bodgery/pico_doorbot/README.md

Required libraries:

* Dictionary: https://github.com/arkhipenko/Dictionary
* Tone32: https://github.com/lbernstone/Tone32
