bodgery/pico_doorbot/pico_hat/pico_hat.kicad_pcb

## KiCad design pico_hat/pico_hat.kicad_pcb (2021-09-29)

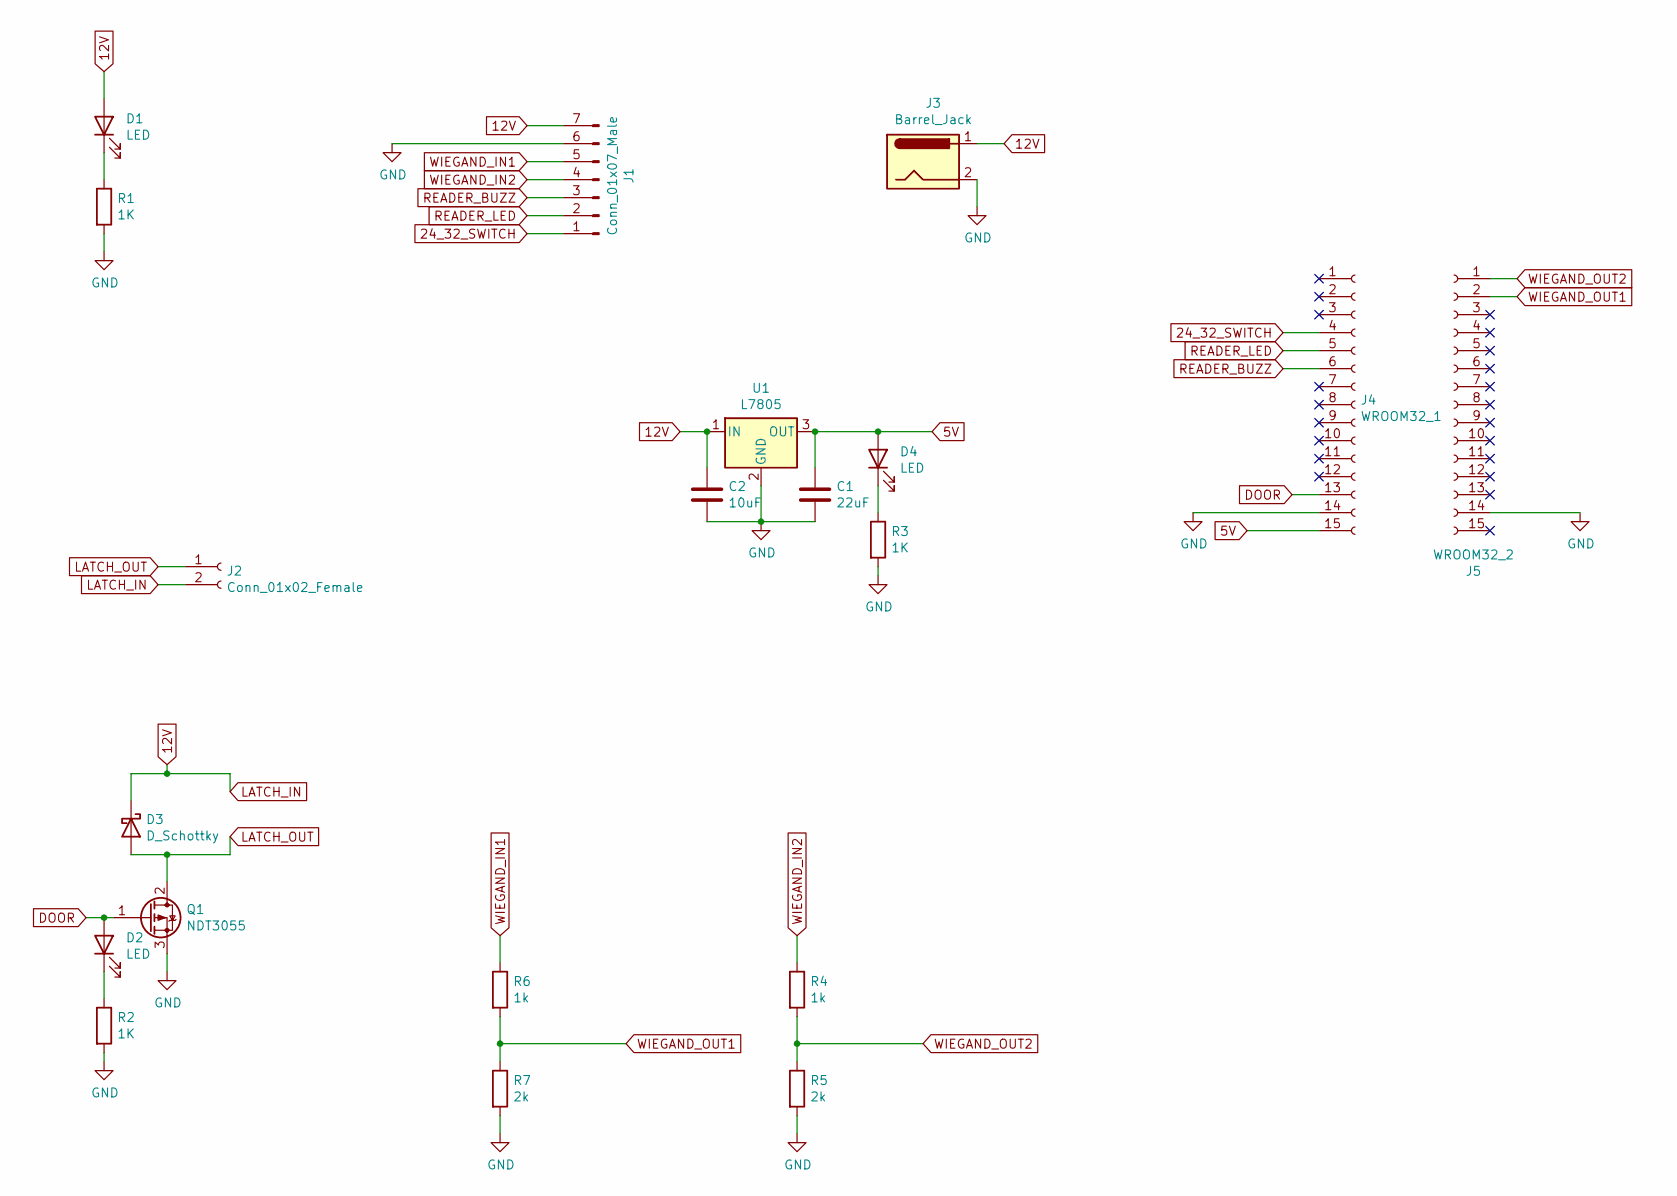
[picture p1: schematic pico_hat.kicad_sch]

Parts:
C1: 22uF; C_1206; Digikey # 1276-1771-2-ND
C2: 10uF; C_1206; Digikey # 1276-6736-1-ND
D1: LED; LED-1206; Digikey # 1516-1073-2-N
D2: LED; LED-1206; Digikey # 1516-1072-2-ND
D3: D_Schottky; SMD-1206_Pol; Digikey # 478-7805-2-ND
D4: LED; LED-1206; Digikey # 1516-1076-2-ND
J1: Conn_01x07_Male; Pin_Header_Straight_1x07
J2: Conn_01x02_Female; TerminalBlock_Pheonix_MKDS1.5-2pol; Digikey # ED2561-ND
J3: Barrel_Jack; TerminalBlock_Pheonix_MKDS1.5-2pol; Digikey # ED2561-ND
J4: WROOM32_1; Pin_Header_Straight_1x15
J5: WROOM32_2; Pin_Header_Straight_1x15
Q1: NDT3055; SOT-223; Digikey # NDT3055CT-ND
R1, R2, R3: 1K; R_1210; Digikey # RMCF1210FT1K00
R4, R6: 1k; R_1210; Digikey # RMCF1210FT1K00
R5, R7: 2k; R_1210; Digikey # P2.0KVTR-ND
U1: L7805; TO-220_Neutral123_Vertical; Digikey # 1470-VR10S05-ND

Connections:
5V: C1.1, D4.2 (A), J4.15, U1.3 (OUT)
12V: C2.1, D1.2 (A), D3.1 (K), J1.7, J2.2, J3.1, U1.1 (IN)
24_32_SWITCH: J1.1, J4.4
DOOR: D2.2 (A), J4.13, Q1.1 (G)
GND: C1.2, C2.2, J1.6, J3.2, J4.14, J5.14, Q1.3 (S), R1.2, R2.2, R3.2, R5.2, R7.2, U1.2 (GND)
LATCH_OUT: D3.2 (A), J2.1, Q1.2 (D), Q1.4
unnamed: D1.1 (K), R1.1
unnamed: D2.1 (K), R2.1
unnamed: D4.1 (K), R3.1
READER_BUZZ: J1.3, J4.6
READER_LED: J1.2, J4.5
WIEGAND_IN1: J1.5, R6.1
WIEGAND_IN2: J1.4, R4.1
WIEGAND_OUT1: J5.2, R6.2, R7.1
WIEGAND_OUT2: J5.1, R4.2, R5.1

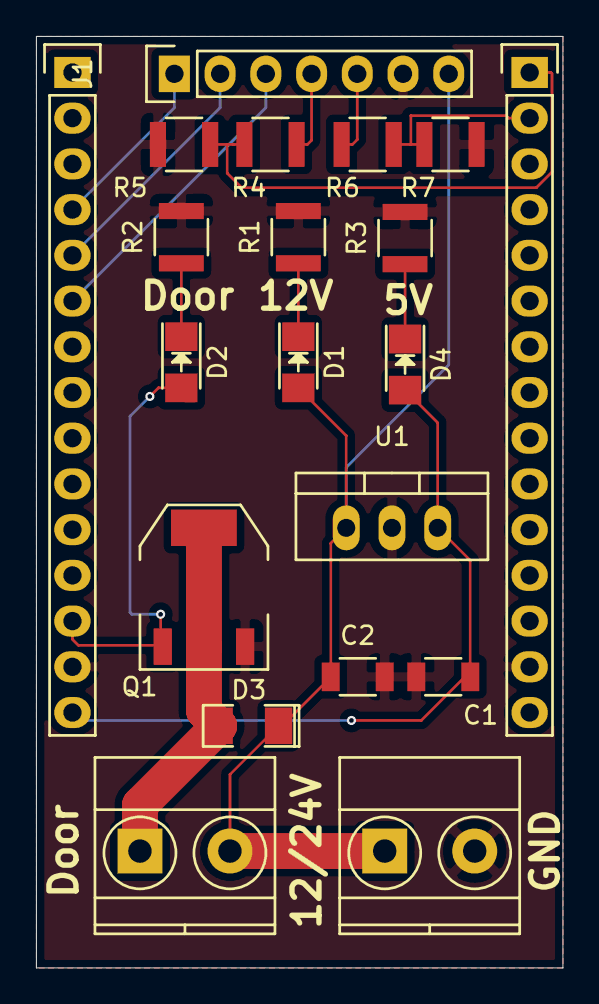
[picture p2: board pico_hat.kicad_pcb from above]

Board: 2 copper layers, 29.2 x 51.8 mm, 20 parts (0 on the bottom side), 15 nets.
