bodgery/pico_doorbot/(commit log)

2021-03-06 Rebuild cache on a timer
2021-03-27 Switch to a polling method of checking Wiegand
2021-03-28 Wiegand PCB connector
    [esp32_doorbot.kicad_pcb, esp32_doorbot.sch]
2021-03-31 Use header that attaches to wesp32 board directly
    [esp32_doorbot.csv, esp32_doorbot.kicad_pcb, esp32_doorbot.sch]
2021-03-31 Add part number for 2x10 pin header
    [esp32_doorbot.sch]
2021-04-23 Change schematic for regular ESP32, not a PoE version
    [esp32_doorbot.sch]
2021-04-24 New layout for regular esp32
    [esp32_doorbot.kicad_pcb, esp32_doorbot.sch]
2021-04-24 Use larger components. Correct pinout and spacing
    [esp32_doorbot.kicad_pcb, esp32_doorbot.sch]
2021-07-03 Switch to voltage divider instead of logic level converter
    [esp32_doorbot.kicad_pcb, esp32_doorbot.sch]
2021-07-20 Voltage dividers
    [esp32_doorbot.csv, esp32_doorbot.sch]
2021-07-27 Move opening the door into success/fail methods
    [esp32_doorbot.ino]
2021-07-31 Correct door pin
2021-09-10 Take a command for opening door. Correct pinout on MOSFET.
    [esp32_doorbot.ino]
2021-09-17 Add stats command. Add some stuff that was missing in the example config
    [esp32_doorbot.ino]
2021-09-26 Correct mosfet pinout (for real this time)
    [esp32_doorbot.kicad_pcb, esp32_doorbot.sch]
2021-09-26 Revert "Correct mosfet pinout (for real this time)"
    This reverts commit 8fe08cf28d7a1d30f1efb70a8aeb7666ade41443.
    [esp32_doorbot.kicad_pcb, esp32_doorbot.sch]
2021-09-26 Even more pinout corrections
    [esp32_doorbot.kicad_pcb, esp32_doorbot.sch]
2021-09-26 Use a through-hole buck converter
    [esp32_doorbot.kicad_pcb, esp32_doorbot.sch]
2021-09-26 Fixup labels
    [esp32_doorbot.kicad_pcb]
2021-09-30 Handle cache rebuild errors more gracefully
    [esp32_doorbot.ino]
2021-10-02 New mosfet
    [esp32_doorbot.sch]
2021-11-21 Add help for commands. Add command to check a fob. Reset cache rebuild time even if we fail, so we don't get an infinite loop
    [esp32_doorbot.ino]
2024-01-10 Convert to new names
    [pico_hat.csv, pico_hat.kicad_pcb, pico_hat.kicad_sch, pico_hat.sch]
2024-01-11 Add screen pin. Remove two of the three LEDs. Sense input.
    [pico_hat.kicad_sch]
2024-01-19 Remove extra LEDs. Connectors for screen and sense input. Move to Pi Pico.
    [pico_hat.kicad_sch]
