bodgery/pico_doorbot/(notices)

Notices in the files:
pico_hat/pico_hat.kicad_pcb:
Copyright © 2021
